joslumar/ARDEC/Board/ARDEC-controller-v1.brd

## EAGLE design Board/ARDEC-controller-v1.brd (2019-11-10)

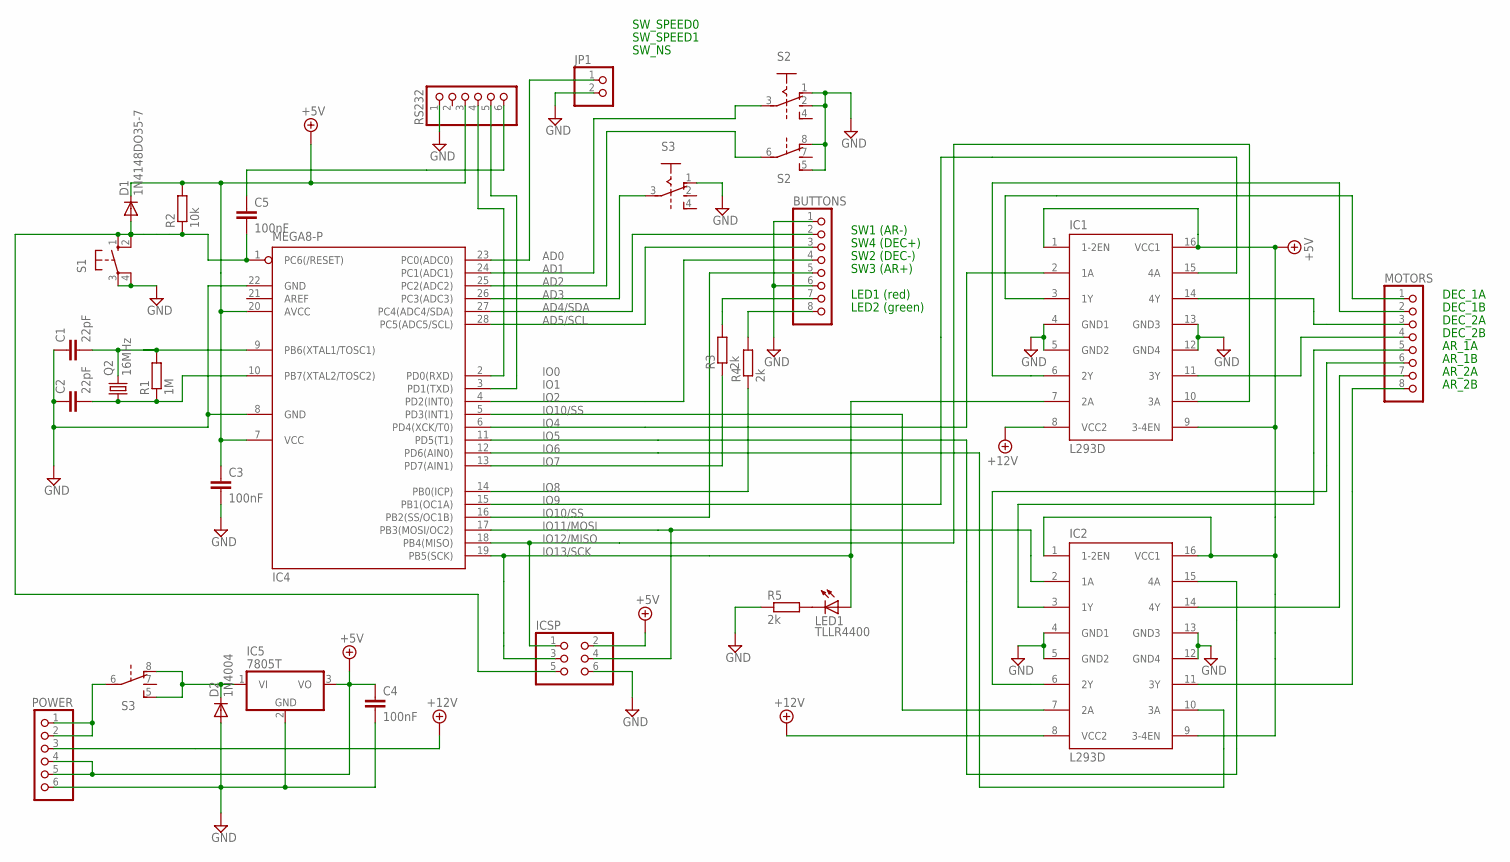
[picture p1: schematic ARDEC-controller-v1.sch]

Parts:
BUTTONS: PINHD-1X8; 1X08
C1, C2: 22pF; C2.5-2
C3, C4, C5: 100nF; C025_050-025X075
D1: 1N4148DO35-7; DO35-7
D2: 1N4004; DO41-10
IC1, IC2: L293D; DIL16
IC4: MEGA8-P; DIL28-3
IC5: 7805T; TO220H
ICSP: PINHD-2X3; 2X03
JP1: PINHD-1X2; 1X02
LED1: TLLR4400; LED3MM
MOTORS: PINHD-1X8; 1X08
POWER: PINHD-1X6; 1X06
Q2: 16MHz; HC18U-H
R1: 1M; 0207/10
R2: 10k; 0207/10
R3, R4, R5: 2k; 0207/10
RS232: PINHD-1X6; 1X06
S1: 10-XX; B3F-10XX
S2, S3: SL2C3P

Connections:
+5V: C3.1, C4.1, D1.C, IC1.1 (1-2EN), IC1.9 (3-4EN), IC1.16 (VCC1), IC2.1 (1-2EN), IC2.9 (3-4EN), IC2.16 (VCC1), IC4.7 (VCC), IC4.20 (AVCC), IC5.3 (VO), ICSP.2, POWER.4, POWER.5, R2.2, RS232.3
+12V: IC1.8 (VCC2), IC2.8 (VCC2), POWER.3
AD0: IC4.23 (PC0(ADC0)), JP1.1
AD1: IC4.24 (PC1(ADC1)), S2.3 (Q)
AD2: IC4.25 (PC2(ADC2)), S2.6 (Q)
AD3: IC4.26 (PC3(ADC3)), S3.3 (Q)
AD4/SDA: BUTTONS.2, IC4.27 (PC4(ADC4/SDA))
AD5/SCL: BUTTONS.3, IC4.28 (PC5(ADC5/SCL))
GND: BUTTONS.1, BUTTONS.6, C1.1, C2.1, C3.2, C4.2, D2.A, IC1.4 (GND1), IC1.5 (GND2), IC1.12 (GND4), IC1.13 (GND3), IC2.4 (GND1), IC2.5 (GND2), IC2.12 (GND4), IC2.13 (GND3), IC4.8 (GND), IC4.22 (GND), IC5.2 (GND), ICSP.6, JP1.2, POWER.6, R5.1, RS232.1, S1.3, S1.4 (P1), S2.1 (O), S2.2, S2.5 (R), S2.8 (O), S3.1 (O)
IO0: IC4.2 (PD0(RXD)), RS232.4
IO1: IC4.3 (PD1(TXD)), RS232.5
IO2: BUTTONS.4, IC4.4 (PD2(INT0))
IO4: IC1.2 (1A), IC4.6 (PD4(XCK/T0))
IO5: IC2.15 (4A), IC4.11 (PD5(T1))
IO6: IC2.10 (3A), IC4.12 (PD6(AIN0))
IO7: IC4.13 (PD7(AIN1)), R3.1
IO8: IC4.14 (PB0(ICP)), R4.1
IO9: IC1.15 (4A), IC4.15 (PB1(OC1A))
IO10/SS: BUTTONS.5, IC4.16 (PB2(SS/OC1B))
IO11/MOSI: IC2.2 (1A), IC4.17 (PB3(MOSI/OC2)), ICSP.4
IO12/MISO: IC1.10 (3A), IC4.18 (PB4(MISO)), ICSP.1
IO13/SCK: IC1.7 (2A), IC4.19 (PB5(SCK)), ICSP.3, LED1.A
unnamed: IC1.3 (1Y), MOTORS.1
unnamed: IC1.6 (2Y), MOTORS.2
unnamed: IC1.14 (4Y), MOTORS.3
unnamed: IC1.11 (3Y), MOTORS.4
unnamed: IC2.3 (1Y), MOTORS.5
unnamed: IC2.6 (2Y), MOTORS.6
unnamed: IC2.14 (4Y), MOTORS.7
unnamed: IC2.11 (3Y), MOTORS.8
unnamed: BUTTONS.8, R4.2
unnamed: BUTTONS.7, R3.2
unnamed: POWER.1, POWER.2, S3.6 (Q)
unnamed: LED1.K (C), R5.2
unnamed: C1.2, IC4.9 (PB6(XTAL1/TOSC1)), Q2.2, R1.2
unnamed: C2.2, IC4.10 (PB7(XTAL2/TOSC2)), Q2.1, R1.1
unnamed: IC2.7 (2A), IC4.5 (PD3(INT1))
unnamed: C5.1, RS232.6
unnamed: D2.C, IC5.1 (VI), S3.5 (R), S3.8 (O)
RESET: C5.2, D1.A, IC4.1 (PC6(/RESET)), ICSP.5, R2.1, S1.1 (S), S1.2 (S1)

Notes on the sheet:
DEC_1A
DEC_1B
DEC_2A
DEC_2B
AR_1A
AR_1B
AR_2A
AR_2B
SW1 (AR-)
SW4 (DEC+)
SW2 (DEC-)
SW3 (AR+)
LED1 (red)
LED2 (green)
SW_NS
SW_SPEED1
SW_SPEED0

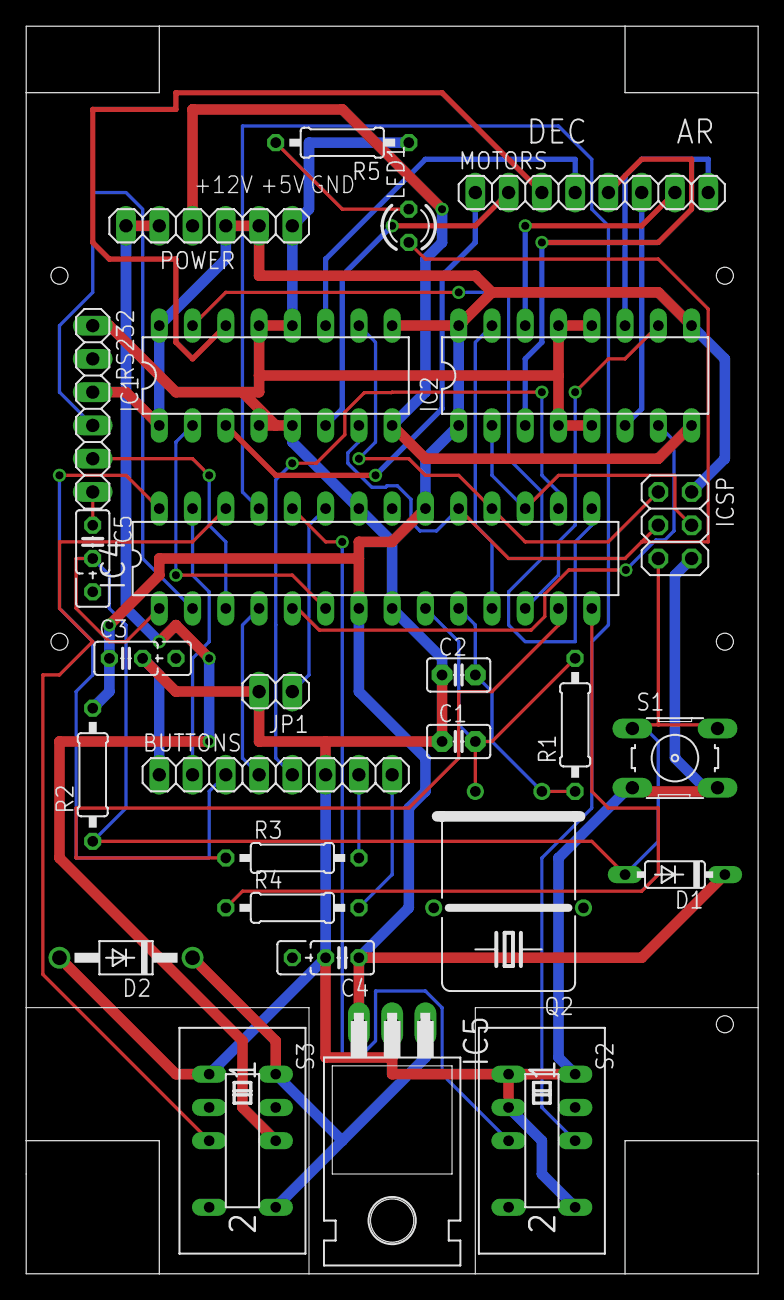
[picture p2: board ARDEC-controller-v1.brd from above]

Board: 2 copper layers, 55.9 x 95.2 mm, 27 parts (0 on the bottom side), 40 nets.
