joslumar/ARDEC/ARDEC.ino

/******************************************************************************************************************************
 *
 * Firmware para programar un ATMEGA328 con IDE Arduino
 * Sustituye funcionalidad del controlador de motores de dos ejes para EQ4 EQ5
 *
 * (C) Jose Luis Marquez Regueiro
 *
 * GPL Licensed (see http://www.fsf.org/copyleft/gpl.txt)
 *
 * Este programa se distribuye SIN GARANTIA de ningun tipo.
 *
 ******************************************************************************************************************************/

#define _VERSION "2.1"

#include <Arduino.h>
#include <TimerOne.h> // Ojo, que me cargo las salidas PWM 9 y 10 (timer1)
// ... y mas ojo, que si activo el serial.print altero el temporizador ... o quizas el tratamiento de interrupciones
// o si no, mira el control de los motores con el osciloscopio o el analizador logico
//#include <EEPROM.h>

/**
  Timer0 TCCR0B pin5,6 millis(),  8bits => 256 values // FastPWM mode
  Setting       Divisor Frequency
  0x01  1       62500
  0x02  8       7812.5
  0x03  64      976.5625 <- default
  0x04  256     244.140625
  0x05  1024    61.03515625
  
  Timer1 TCCR1B, 16bits => 65536 values
  Setting       Divisor Frequency
  0x01  1       244.1406250
  0x02  8       30.517578125
  0x03  64
  0x04  256
  0x05  1024

  Timer2 TCCR2B, pin3,11  8bits => 256 values // FastPWM mode
  Setting       Divisor Frequency
  0x01  1       62500
  0x02  8       7812.5
  0x03  32      1953.125
  0x04  64      976.5625
  0x05  128     488.28125
  0x06  256     244.140625
  0x07  1024    61.03515625
**/
#define TIMERSPRESCALER 8 // 1 8

#if TIMERSPRESCALER == 1
#define TIMERPRESCALER0_VALUE B001
#define TIMERPRESCALER2_VALUE B001
#elif TIMERSPRESCALER == 8
#define TIMERPRESCALER0_VALUE B010
#define TIMERPRESCALER2_VALUE B010
#elif TIMERSPRESCALER == 64
#define TIMERPRESCALER0_VALUE B011
#define TIMERPRESCALER2_VALUE B100
#endif

#define millis() ( millis() / TIMERSPRESCALER )
#define micros() ( micros() / TIMERSPRESCALER )

#define CLK_ADJ 1.02458 // 1.0236 // 1.0243
#define compensated_millis() ( millis() * CLK_ADJ ) 
#define compensated_micros() ( micros() * CLK_ADJ )

#define _CALIBRATE

#define _AR_MOTOR_DEBUG  0
#define _DEC_MOTOR_DEBUG 0

#define B_AR_UP    0b0010
#define B_AR_DOWN  0b0001
#define B_DEC_UP   0b1000
#define B_DEC_DOWN 0b0100

#define B_AR       0b0011
#define B_DEC      0b1100

// microsteps table
// octave:
// n=128; A=[round(sin([0:n/2-1]*pi/n*2)*255), zeros(1,n/2)]; A
// MS=16 ; B=[]; for i = 0:MS-1 ; B=[B A(i*n/MS+1)] ; endfor ; 
#define MAXMICROSTEPS 32 // son 128 micropasos / ciclo
volatile const byte pwmStepsTable[MAXMICROSTEPS<<1]={
  0,  13,  25,  37,  50,  62,  74,  86,
  98, 109, 120, 131, 142, 152, 162, 171,
  180, 189, 197, 205, 212, 219, 225, 231,
  236, 240, 244, 247, 250, 252, 254, 255,
  255, 255, 254, 252, 250, 247, 244, 240,
  236, 231, 225, 219, 212, 205, 197, 189,
  180, 171, 162, 152, 142, 131, 120, 109,
  98 ,  86,  74,  62,  50,  37,  25,  13
};

#define MAXRELAX_DEC  250

#define PIN_INFO_LED    8
#define PIN_PWR_LED     7

#define PIN_BOBINA_AR_1A 11 // PWM  timer 2
#define PIN_BOBINA_AR_1B 3  // PWM  timer 2
#define PIN_BOBINA_AR_2A 5  // PWM  timer 0
#define PIN_BOBINA_AR_2B 6  // PWM  timer 0

#define PIN_BOBINA_DEC_1A  4   // no PWM
#define PIN_BOBINA_DEC_1B  13  // no PWM
#define PIN_BOBINA_DEC_2A  9   // no PWM (broken by TimerOne, timer1)
#define PIN_BOBINA_DEC_2B  12  // no PWM


#define PIN_AR_UP   10    // AR+   O10 PWM broken by TimerOne, timer1
#define PIN_AR_DOWN A4    // AR-
#define PIN_DEC_UP  A5    // DEC+
#define PIN_DEC_DOWN 2    // DEC-

#define PIN_NS     A3
#define PIN_SPEED0 A2
#define PIN_SPEED1 A1

#define UP   0
#define DOWN 1
#define NORTH 0
#define SOUTH 1

#define AR_MOTOR 0
#define DEC_MOTOR 1

/*
 **** Original Synta motors:
 Motor Step Angle: 7.5 degrees => 48 steps / turn
 Motor Gear Ratio: 120:1
 Worm Gear Ratio:  144:1
 
 1 step   = 1.5625  arcsec
 1/2 step = 0.78125 arcsec
 
 Secconds in a day:  24*60*60*0.99726958 = 86164s (23 hours, 56 minutes, 4.0916 seconds)
 
 4.9863s = 1 motor turns => 1s sidereal time => v motor = 9.6263 steps / s = 19.253 usteps / s [1/2 step]
 
 
 single step:
 sidereal time (t step) = 103.88 ms
 max speed = 8x => tick =  12.985 ms
 max speed = 16x => tick =  6.4926 ms // no lo aguanta el motor de la EQ5 (los motores del dual axis son lentos de c*jones)
 max speed = 32x => tick =  3.2462 ms // no lo aguanta el motor de la EQ5
 
 1/2 step:
 sidereal time (t step) = 51.941 ms
 max speed = 8x => tick =  6.4926 ms  // mitad de consumo que single step  <- tamaños de pulso en AR de 155,832ms(H) y 259,720ms(L)
 max speed = 16x => tick =  3.2462 ms // no lo aguanta el motor de la EQ5
 max speed = 32x => tick =  1.6231 ms // no lo aguanta el motor de la EQ5

 **** 17HS13-0404S1 1.8 deg/step

 Pulley Gear Ratio: 4:1
 Worm Gear Ratio:  144:1

 1 step = 11.25 arcseg 
 1/8 step = 1.40625 arcseg  (DEC)  Analog outputs
 1/16 step = .703125 arcseg (AR)   PWM outputs

 single step: 
 sidereal time (t step) = 750 ms

 1/16 step: 
 sidereal time (t step) = 46.875 ms (STEP_USEC)
 max speed = 32x => tick =  1.46484375 ms = 1464.84375 us (TICK_USEC)
 max speed = 64x => tick =  0.732421875 ms = 732.421875 us

 */

/***** synta ****
#define SPEED_MAX  32
#define TICK_USEC 6493+2 // half step 8x // 6493+2 <- correccion
unsigned int AR_microSteps  = 2; // 8 pasos por ciclo
unsigned int DEC_microSteps = 2; // 8 pasos por ciclo
/*****/

/***** 17HS13-0404S1 *****/
#define SPEED_MAX 32
#define STEP_USEC 46875
#define TICK_USEC STEP_USEC/SPEED_MAX // 1/16 step, 32x
#define AR_MICROSTEPS 16
unsigned int AR_microSteps = AR_MICROSTEPS; // 64 pasos por ciclo
unsigned int DEC_microSteps = 2; // 64 pasos por ciclo
/******/


volatile unsigned long ticks = 0;

volatile boolean interrupting_t1 = false;

volatile boolean hemisphere = NORTH; // NORTH SOUTH
volatile byte motion_speed  = 4;   // 2, 4, 8
volatile boolean superspeed = false;

volatile short int step_AR  = 0;  // 0 .. AR_ULTIMOPASO
volatile short int step_DEC = 0;  // 0 .. DEC_ULTIMOPASO

volatile int delay_tick_ar;  // tiempo muerto mientras espera el siguiente slot tick para cumplir con la velocidad del mando
volatile int delay_tick_dec; // tiempo muerto mientras espera el siguiente slot tick para cumplir con la velocidad del mando

volatile long int ar_motorPos   = 0;   // paso en curso del motor AR
volatile long int dec_motorPos  = 0;   // paso en curso del motor DEC
volatile long int ar_targetPos  = 0;   // paso deseado del motor AR
volatile long int dec_targetPos = 0;   // paso deseado del motor DEC

volatile int relax_dec = 0;          // solo relajo el DEC

char tmp_str[256]; // resulting string limited to 256 chars

int pulsado;
int boton;

//---------------------------------

void relaja_motor_AR() {
  digitalWrite(PIN_BOBINA_AR_1A, LOW);
  digitalWrite(PIN_BOBINA_AR_1B, LOW);  
  digitalWrite(PIN_BOBINA_AR_2A, LOW);
  digitalWrite(PIN_BOBINA_AR_2B, LOW);
}

void relaja_motor_DEC() {
  digitalWrite(PIN_BOBINA_DEC_1A, LOW);
  digitalWrite(PIN_BOBINA_DEC_1B, LOW);  
  digitalWrite(PIN_BOBINA_DEC_2A, LOW);
  digitalWrite(PIN_BOBINA_DEC_2B, LOW);
}

void relaja_motores() {
  relaja_motor_AR();
  relaja_motor_DEC();
}

// pasos completos
void doMotorStep4(int step, int pin_1A, int pin_1B, int pin_2A, int pin_2B)
{
  switch(step)
  {
  case 0:         //paso 0
    digitalWrite(pin_1A, HIGH);
    digitalWrite(pin_1B, LOW);
    digitalWrite(pin_2A, HIGH);
    digitalWrite(pin_2B, LOW);
    break;        
  case 1:         //paso 1
    digitalWrite(pin_1A, HIGH);
    digitalWrite(pin_1B, LOW);
    digitalWrite(pin_2A, LOW);
    digitalWrite(pin_2B, HIGH);
    break;        
  case 2:         //paso 2
    digitalWrite(pin_1A, LOW); 
    digitalWrite(pin_1B, HIGH);
    digitalWrite(pin_2A, LOW);
    digitalWrite(pin_2B, HIGH);
    break;        
  case 3:         //paso 3
    digitalWrite(pin_1A, LOW); 
    digitalWrite(pin_1B, HIGH);
    digitalWrite(pin_2A, HIGH);
    digitalWrite(pin_2B, LOW);
    break;
  }
}

// medios pasos
void doMotorStep8(int step, int pin_1A, int pin_1B, int pin_2A, int pin_2B)
{
  switch(step)
  {
  case 0:         //paso 0
    digitalWrite(pin_1A, HIGH);
    digitalWrite(pin_1B, LOW);
    digitalWrite(pin_2A, HIGH);
    digitalWrite(pin_2B, LOW);
    break;        
  case 1:         //paso 1
    digitalWrite(pin_1A, HIGH);
    digitalWrite(pin_1B, LOW);
    digitalWrite(pin_2A, LOW);
    digitalWrite(pin_2B, LOW);
    break;
  case 2:         //paso 2
    digitalWrite(pin_1A, HIGH);
    digitalWrite(pin_1B, LOW);
    digitalWrite(pin_2A, LOW);
    digitalWrite(pin_2B, HIGH);
    break;
  case 3:         //paso 3
    digitalWrite(pin_1A, LOW);
    digitalWrite(pin_1B, LOW);
    digitalWrite(pin_2A, LOW);
    digitalWrite(pin_2B, HIGH);
    break;
  case 4:         //paso 4
    digitalWrite(pin_1A, LOW);
    digitalWrite(pin_1B, HIGH);
    digitalWrite(pin_2A, LOW);
    digitalWrite(pin_2B, HIGH);
    break;
  case 5:         //paso 5
    digitalWrite(pin_1A, LOW);
    digitalWrite(pin_1B, HIGH);
    digitalWrite(pin_2A, LOW);
    digitalWrite(pin_2B, LOW);
    break;
  case 6:         //paso 6
    digitalWrite(pin_1A, LOW);
    digitalWrite(pin_1B, HIGH);
    digitalWrite(pin_2A, HIGH);
    digitalWrite(pin_2B, LOW);
    break;
  case 7:         //paso 7
    digitalWrite(pin_1A, LOW);
    digitalWrite(pin_1B, LOW);
    digitalWrite(pin_2A, HIGH);
    digitalWrite(pin_2B, LOW);
    break;
  }
}

// devuelve el valor de la potencia de pulso para la posicion del micropaso absoluto pos
int getpwmbyStep(int pos, int microSteps) {

  pos = pos % (microSteps<<2); // microSteps => 1 cuadrante => x4
  if (pos == 0)
    pos = microSteps<<2;

  unsigned int index = ((pos - 1) * MAXMICROSTEPS) / microSteps;
  return ( index < (MAXMICROSTEPS<<1) ? pwmStepsTable[index] : 0 );  // solo tengo medio cuadrante en el array, el resto es cero
}

void doMotorStep(int step, unsigned int microSteps, char motor)
{
  int pin_1A, pin_1B, pin_2A, pin_2B;
       
  switch (motor) {
     case AR_MOTOR:
       pin_1A = PIN_BOBINA_AR_1A;
       pin_1B = PIN_BOBINA_AR_1B;
       pin_2A = PIN_BOBINA_AR_2A;
       pin_2B = PIN_BOBINA_AR_2B;
       break;
    case DEC_MOTOR:
       pin_1A = PIN_BOBINA_DEC_1A;
       pin_1B = PIN_BOBINA_DEC_1B;
       pin_2A = PIN_BOBINA_DEC_2A;
       pin_2B = PIN_BOBINA_DEC_2B;
       break;
  }
  if (microSteps>2) {
    analogWrite(pin_1A, getpwmbyStep(step, microSteps));
    analogWrite(pin_1B, getpwmbyStep(step + (microSteps<<1) , microSteps )); // microSteps * 2 ; microSteps => 1 cuadrante
    analogWrite(pin_2A, getpwmbyStep(step +  microSteps     , microSteps )); // microSteps
    analogWrite(pin_2B, getpwmbyStep(step +  microSteps * 3 , microSteps )); // microSteps * 3

#if _AR_MOTOR_DEBUG || _DEC_MOTOR_DEBUG
    if (motor == AR_MOTOR && _AR_MOTOR_DEBUG) {
       sprintf( tmp_str, "AR(%03u:%03u:%03u:%03u)",
         getpwmbyStep(step, microSteps),getpwmbyStep(step+(microSteps<<1), microSteps),
         getpwmbyStep(step+microSteps, microSteps), getpwmbyStep(step+microSteps*3, microSteps));
       Serial.print(tmp_str);
     }
    else if (motor == DEC_MOTOR && _DEC_MOTOR_DEBUG ) {
       sprintf( tmp_str, "DEC(%03u:%03u:%03u:%03u)",
         getpwmbyStep(step, microSteps),getpwmbyStep(step+(microSteps<<1), microSteps),
         getpwmbyStep(step+microSteps, microSteps), getpwmbyStep(step+microSteps*3, microSteps));
       Serial.print(tmp_str);
    }
#endif
  }
  else if (microSteps==2) {
    doMotorStep8(step, pin_1A, pin_1B, pin_2A, pin_2B);
  }
  else if (microSteps==1) {
    doMotorStep4(step, pin_1A, pin_1B, pin_2A, pin_2B);
  }
}


int calcARMotorStep(bool sentido) {
  switch (hemisphere) {
  case NORTH:
    if ( sentido ) {
      if ( step_AR < (AR_microSteps<<2) - 1 )
        step_AR++;
      else
        step_AR = 0;

      ar_motorPos++;
    }
    else {
      if ( step_AR > 0 )
        step_AR--;
      else
        step_AR = (AR_microSteps<<2) - 1; 

      ar_motorPos--;
    }
    break;
  case SOUTH:
    if ( sentido ) {
      if ( step_AR > 0 )
        step_AR--;
      else
        step_AR = (AR_microSteps<<2) - 1; 

      ar_motorPos++;
    }
    else {
      if ( step_AR < (AR_microSteps<<2) - 1 )
        step_AR++;
      else
        step_AR = 0;

      ar_motorPos--;
    }
    break;
  }
  return(1); // future AR limits setup
}

int calcDECMotorStep(bool sentido) {
  if ( sentido ) {
    if ( step_DEC < (DEC_microSteps<<2) - 1 )
      step_DEC++;
    else
      step_DEC = 0;

    dec_motorPos++;
  }
  else {
    if ( step_DEC > 0 )
      step_DEC--;
    else
      step_DEC = (DEC_microSteps<<2) - 1;

    dec_motorPos--;
  }
  return(1); // future DEC limits setup
}


///-----------------------


volatile unsigned long last_ar_step = 0;
volatile unsigned long last_compensated_micros = 0;

void interrup_t1() {
  int diff_ar = 0;
  int diff_dec = 0;
  unsigned long this_last_ar_step;
  unsigned long this_compensated_micros;

  if (!interrupting_t1) {
    interrupting_t1 = true;

//    if ( ticks % SPEED_MAX == 0) {   // sidereal (vel max 8x), un slot de 8

    this_compensated_micros = compensated_micros(); // prevents long (32bits) overflow
    this_last_ar_step = (unsigned long) ( this_compensated_micros / (long) STEP_USEC ); // o'clock to move
    if ( this_last_ar_step > last_ar_step || this_compensated_micros < last_compensated_micros ) {
       last_ar_step = this_last_ar_step;
       last_compensated_micros = this_compensated_micros;
       ar_targetPos++;
       delay_tick_ar = 0; // ya!
    }
    
    //---------------- MOTOR AR
    //
    if ( delay_tick_ar == 0 ) { // no hay que esperar mas a slot
      delay_tick_ar =  SPEED_MAX/motion_speed - 1;  // velocidad 8x => no espera (11111111) ; velocidad 2x => espera 3 (10001000)
      diff_ar = ar_targetPos - ar_motorPos;
      if ( diff_ar ) { // si hay pasos pendientes, mueve el motor
        if ( calcARMotorStep( diff_ar >0 ) == 1 )  { // calcula siguiente paso AR
          doMotorStep(step_AR, AR_microSteps, AR_MOTOR); // mueve al siguiente paso AR
        }
        diff_ar = ar_targetPos - ar_motorPos; // vuelve a calcular pasos pendientes
        /*
         Serial.print("AR:"); 
         Serial.print(ticks);
         Serial.print(" "); 
         Serial.print(diff_ar); 
         Serial.print("\n");
         */
      }
    }
    else { // hay que esperar al slot
      if ( delay_tick_ar ) {
        delay_tick_ar--;
      }
    }
    //---------------- MOTOR DEC
    //
    if ( delay_tick_dec == 0 ) {  // delay tick es cero, no hay que esperar slot
      delay_tick_dec =  SPEED_MAX/motion_speed - 1;  // velocidad 8x => no espera (11111111) ; velocidad 2x => espera 3 (10001000)
      diff_dec = dec_targetPos - dec_motorPos; // calcula ticks pendientes
      if ( diff_dec ) {  // si hay pasos pendientes, mueve el motor
        if ( calcDECMotorStep( diff_dec > 0 ) == 1 ) { // calcula siguiente paso de motor DEC
          doMotorStep(step_DEC, DEC_microSteps, DEC_MOTOR); // mueve al siguiente paso de motor DEC
        }
        diff_dec = dec_targetPos - dec_motorPos;  // vuelve a calcular pasos pendientes
         /*
         Serial.print("DEC:");
         Serial.print(" "); 
         Serial.print(ticks);
         Serial.print(" "); 
         Serial.print(diff_dec); 
         Serial.print(delay_tick_dec); 
         Serial.print("\n");
         */
        relax_dec = MAXRELAX_DEC;  // se ha movido, entonces no relajes por MAXRELAX_DEC
      }
    } 
    else { // hay que esperar ranura
      if ( delay_tick_dec > 0 ) {
        delay_tick_dec--;
      }
    }
    if ( relax_dec > 0 ) { // si estoy esperando relajacion, comienza la cuenta atras ...
      relax_dec--;
      if ( relax_dec == 0 ) { 
        //Serial.print("RELAJANDO\n"); 
        relaja_motor_DEC();
      }
    }
    else
      relax_dec = MAXRELAX_DEC; // espera un tiempo (ticks) hasta relajacion de motor DEC (el AR nunca se relaja)
  }

  if( millis()/1000 % 2) { // cada segundo, keepalive
    digitalWrite(PIN_PWR_LED, HIGH);   // turn the LED on
  }
  else
    digitalWrite(PIN_PWR_LED, LOW);    // turn the LED off

  // calibracion
  // stty -F /dev/ttyUSB0 raw ;  ts "%.s" < /dev/ttyUSB0  | \
  // awk 'BEGIN {t=0} ; ! /V/ {if (t==0) {s=$5;t=$1} else {print "s:"$5" t:"$1" T:"($5-s)/($1-t)*1000}}'
  // stty -F /dev/ttyUSB0 raw ;  ts "%.s" < /dev/ttyUSB0  | \
  // awk 'BEGIN {t=0} ;
  //    ! /V/ {if (t<30) {t=$1;m=$2;mc=$3} else {print "rt:"$1-t" m:"($2-m)/1000" mc:"($3-mc)/1000" adj:"($1-t)/($2-m)*1000}}'
  
#ifdef _CALIBRATE
  if( ticks % 1000 == 0) { // cada 1000 ticks 
    Serial.print(millis()); // OJO con el cambio de frecuencia del timer0 !!!
    Serial.print(" ");
    Serial.print((unsigned long)compensated_millis());
    Serial.print(" ");
    Serial.print(micros());
    Serial.print(" ");
    Serial.print((unsigned long)compensated_micros());
    Serial.print(" ");
    Serial.print(ticks);
    Serial.print(" ");
    Serial.print(last_ar_step);
    Serial.print(" ");
    Serial.print(ar_targetPos);
    Serial.print("\n");
  }
#endif

  ticks++;
  interrupting_t1 = false; // fin interrupcion
}

void stopAR() {  
  delay_tick_ar = 0;
  ar_targetPos = ar_motorPos;
}

void stopDEC() {  
  delay_tick_dec = 0;
  dec_targetPos = dec_motorPos;
}

void moveAR(bool sentido,int steps,boolean prio) {
  switch( sentido ) {
  case UP:
    ar_targetPos += steps;
    break;
  case DOWN:
    ar_targetPos -= steps;
    break;
  }
  if (prio)
    delay_tick_ar = 0;

}

void moveDEC(bool sentido,int steps,boolean prio) {
  switch( sentido ) {
  case UP:
    dec_targetPos += steps;
    break;
  case DOWN:
    dec_targetPos -= steps;
    break;
  }
  if (prio)
    delay_tick_dec = 0;
}

//--------------------------------------------------------------------

int botones() {
  int rc = 0;

  if( digitalRead(PIN_AR_UP)== LOW)    rc += B_AR_UP;
  if( digitalRead(PIN_AR_DOWN)== LOW)  rc += B_AR_DOWN;
  if( digitalRead(PIN_DEC_UP)== LOW)   rc += B_DEC_UP;
  if( digitalRead(PIN_DEC_DOWN)== LOW) rc += B_DEC_DOWN;

  return(rc);
}


byte speed_switches() {
  byte s = (digitalRead(PIN_SPEED1) << 1 ) + digitalRead(PIN_SPEED0);
  switch (s) {
  case 0:
    return(2);  // 2x
    break;
  case 1:
    return(4);  // 4x
    break;
  case 2:
    return(8);  // 8x
    break;
  }
}

volatile bool sentido_ar, sentido_dec;
void botonera() {
  boolean ar_prio = false, dec_prio = false;

  if( millis()/1000 % 2 ) {// cada segundo leo la velocidad del switch
    if (!superspeed)
      motion_speed = speed_switches();
    else
      motion_speed = SPEED_MAX;
  }
  boton = botones();
  switch( boton ) {
  case B_AR_DOWN:
    sentido_ar = DOWN;
    break;
  case B_AR_UP:
    sentido_ar = UP;
    break;
  case B_DEC_DOWN:
    sentido_dec = DOWN;
    break;
  case B_DEC_UP:
    sentido_dec = UP;
    break;
  }

  if ( boton & B_AR ) {
    AR_microSteps = 2;
    if ( !pulsado ) {     // no estaba pulsado antes
      ar_prio = true;
    }
    moveAR(sentido_ar,1,ar_prio);
    pulsado = true;
    digitalWrite(PIN_INFO_LED, HIGH);   // turn the LED on
    /*
    Serial.print("AR:"); 
     Serial.print(ar_motorPos);
     Serial.print("\t");
     Serial.print(motion_speed);
     Serial.print("\n");
     */
    if ( boton == B_AR )
      superspeed=true;
    else
      superspeed=false;
  } 
  else if ( boton & B_DEC ) {
    if ( !pulsado ) {      // no estaba pulsado antes
      dec_prio = true;
    }
    moveDEC(sentido_dec,1,dec_prio);
    pulsado = true;
    digitalWrite(PIN_INFO_LED, HIGH);   // turn the LED on

    /*
    Serial.print("DEC:"); 
     Serial.print(dec_motorPos);
     Serial.print("\t");
     Serial.print(motion_speed);
     Serial.print("\n");
     */

    if ( boton == B_DEC )
      superspeed=true;
    else  
      superspeed=false;
  } 
  else { // no se han pulsado botones ahora
    if ( pulsado ) {   // estaba pulsado antes, pero ahora no. Entonces paro de actuar motores
      stopDEC();
      stopAR();
    } 
    else
      digitalWrite(PIN_INFO_LED, LOW);   // turn the LED off

    pulsado = false;    
    superspeed=false;
    AR_microSteps = AR_MICROSTEPS;
  }
}

void setup() {

  // initialize serial communication:
  Serial.begin(9600L);
  Serial.print("V:"); 
  Serial.print(_VERSION);
  Serial.print(" CLK_ADJ:"); 
  Serial.print(CLK_ADJ,8);
  Serial.print("\n");

  // initialize the buttons pin as a input:
  pinMode(PIN_DEC_UP, INPUT);
  digitalWrite(PIN_DEC_UP, HIGH);       // turn on pullup resistors
  pinMode(PIN_AR_UP, INPUT);
  digitalWrite(PIN_AR_UP, HIGH);
  pinMode(PIN_AR_DOWN, INPUT);
  digitalWrite(PIN_AR_DOWN, HIGH); 
  pinMode(PIN_DEC_DOWN, INPUT);
  digitalWrite(PIN_DEC_DOWN, HIGH);
  pinMode(PIN_NS, INPUT);
  digitalWrite(PIN_NS, HIGH);
  pinMode(PIN_SPEED0, INPUT);
  digitalWrite(PIN_SPEED0, HIGH);
  pinMode(PIN_SPEED1, INPUT);
  digitalWrite(PIN_SPEED1, HIGH);


  TCCR0B = TCCR0B & 0b11111000 | TIMERPRESCALER0_VALUE; // Timer0
  TCCR2B = TCCR2B & 0b11111000 | TIMERPRESCALER2_VALUE;  // Timer2

  TCCR2A = _BV(COM2A1) | _BV(COM2B1) | _BV(WGM21) | _BV(WGM20); // FastPWM Timer2 (256 values)
  
  // initialize the LEDs as an output
  pinMode(PIN_PWR_LED, OUTPUT);  
  digitalWrite(PIN_PWR_LED, LOW);   // turn the LED off
  pinMode(PIN_INFO_LED, OUTPUT);  
  digitalWrite(PIN_INFO_LED, LOW);   // turn the LED off

  // initialize the AR motor phases
  pinMode(PIN_BOBINA_AR_1A, OUTPUT);
  pinMode(PIN_BOBINA_AR_1B, OUTPUT);
  pinMode(PIN_BOBINA_AR_2A, OUTPUT);
  pinMode(PIN_BOBINA_AR_2B, OUTPUT);

  // initialize the DEC motor phases
  pinMode(PIN_BOBINA_DEC_1A, OUTPUT);
  pinMode(PIN_BOBINA_DEC_1B, OUTPUT);
  pinMode(PIN_BOBINA_DEC_2A, OUTPUT);
  pinMode(PIN_BOBINA_DEC_2B, OUTPUT);

  if(digitalRead(PIN_NS)== LOW)
    hemisphere = NORTH;
  else
    hemisphere = SOUTH;

  doMotorStep(step_AR, AR_microSteps, AR_MOTOR);
  doMotorStep(step_DEC, DEC_microSteps, DEC_MOTOR);

  // initialize timer1
  Timer1.initialize(TICK_USEC); // Note that this breaks analogWrite() for digital pins 9 and 10 on Arduino.
  Timer1.attachInterrupt(interrup_t1);

  digitalWrite(PIN_INFO_LED, HIGH);   // turn the LED off
  delay(500);  
  digitalWrite(PIN_INFO_LED, LOW);   // turn the LED off
}


void loop() {
  botonera();
  delay(5);
}

// Local Variables:
// mode: c++
// End:
