joslumar/ARDEC/(commit log)

2017-05-20 new file: Board/ARDEC-controller-v1.brd new file: Board/ARDEC-controller-v1.sch
    [ARDEC-controller-v1.brd, ARDEC-controller-v1.sch]
2019-11-10 Version 2.0
    [ARDEC-controller-v1.brd, ARDEC-controller-v1.sch]
